alexandrospetkos/quad/resources/Photos/img3.png

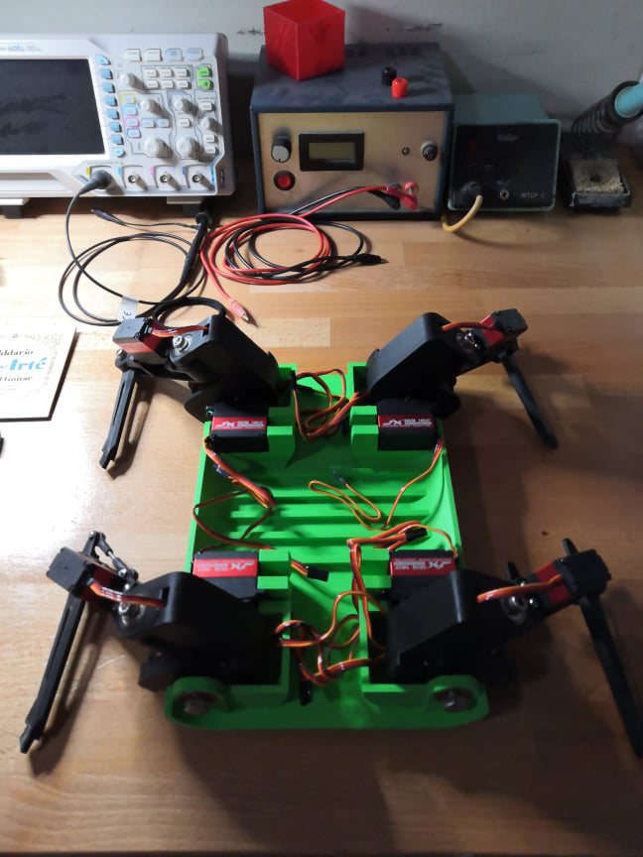
resources/Photos/img3.png
