alexandrospetkos/quad/resources/Photos/img2.png

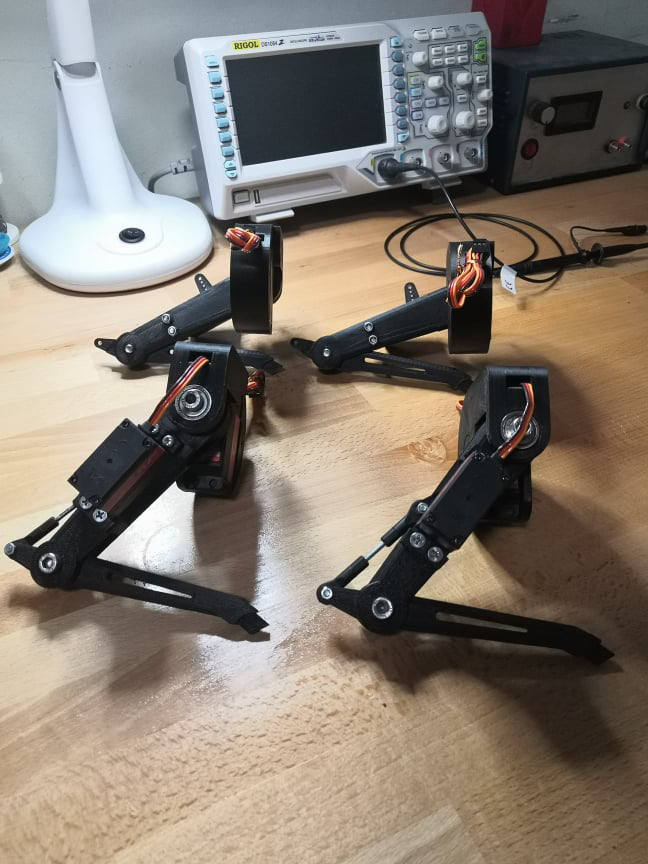
resources/Photos/img2.png
