alexandrospetkos/quad/simulation/README.md

# Warp

 Quadruped robot kinematics simulation/demonstration sketch.
 3/10/2020 by Alexandros Petkos
 Updates available at https://github.com/maestrakos/warp
 
 The code has been tested using Processing version 3.5.4 
 , this sketch is part of warp_kinematics placed under CC-BY.
