alexandrospetkos/quad/source code/source_k210/README.md

I am using the Sipeed M1 Dock with the K210 processor which handles machine vision and communicates with the Esp32 
via UART, passing three values direction-x / direction-y / turn. You essentially need 4 wires to connect 
the two boards vcc ground tx & rx.
