alexandrospetkos/quad/resources/CAD/Diagrams/diagram.png

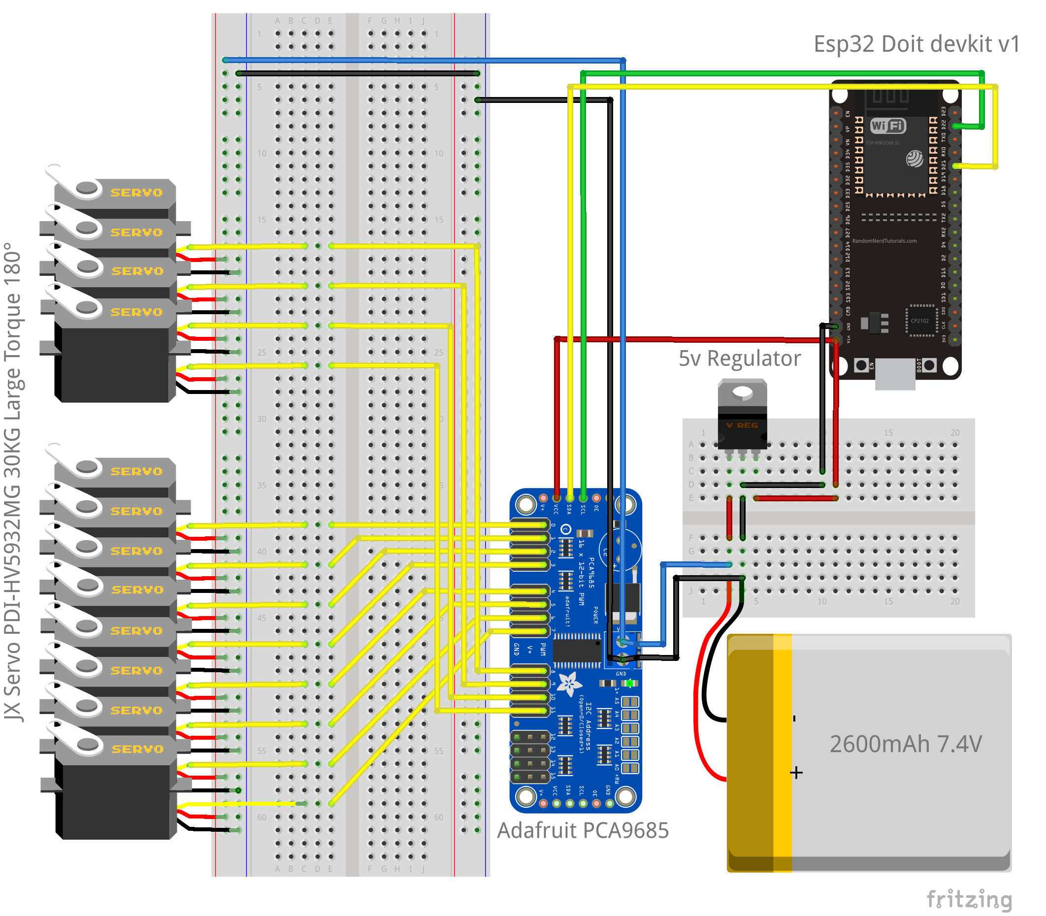
resources/CAD/Diagrams/diagram.png
