alexandrospetkos/quad/resources/CAD/Renders/preview_design.png

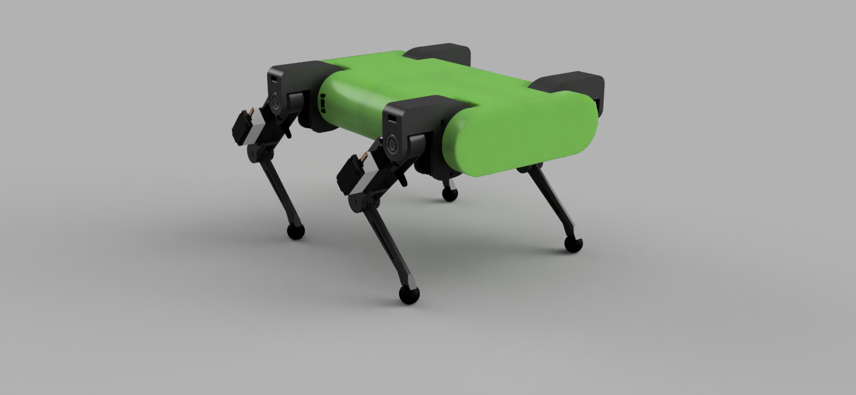
resources/CAD/Renders/preview_design.png
