alexandrospetkos/quad/resources/Photos/img0.png

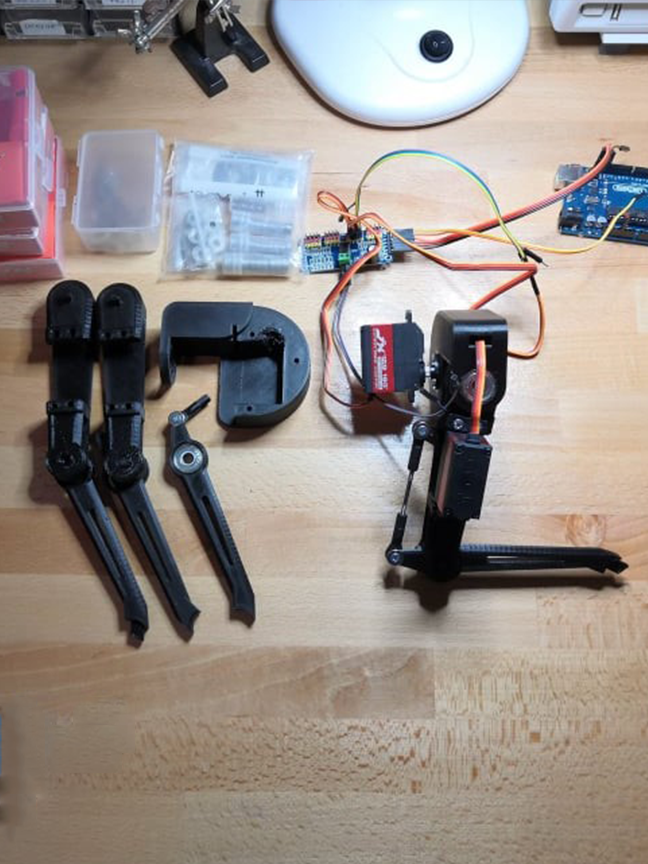
resources/Photos/img0.png
