alexandrospetkos/quad/resources/Photos/img1.png

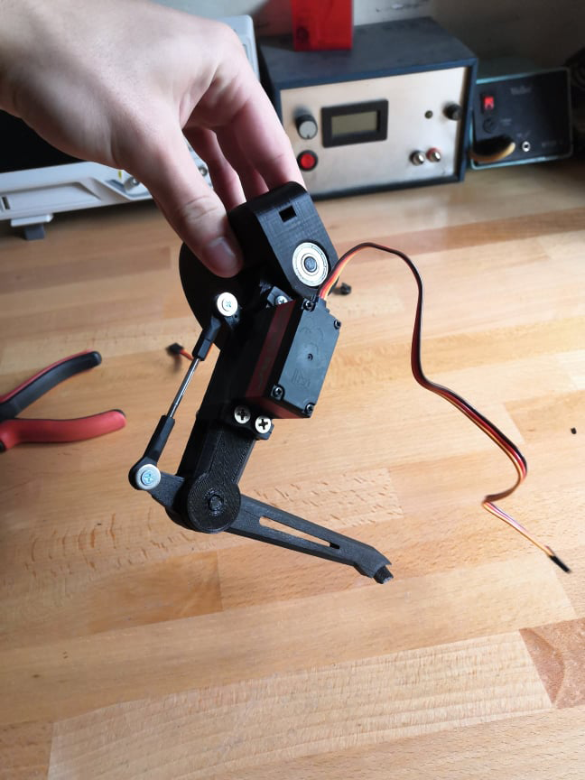
resources/Photos/img1.png
