alexandrospetkos/quad/thumb.jpg

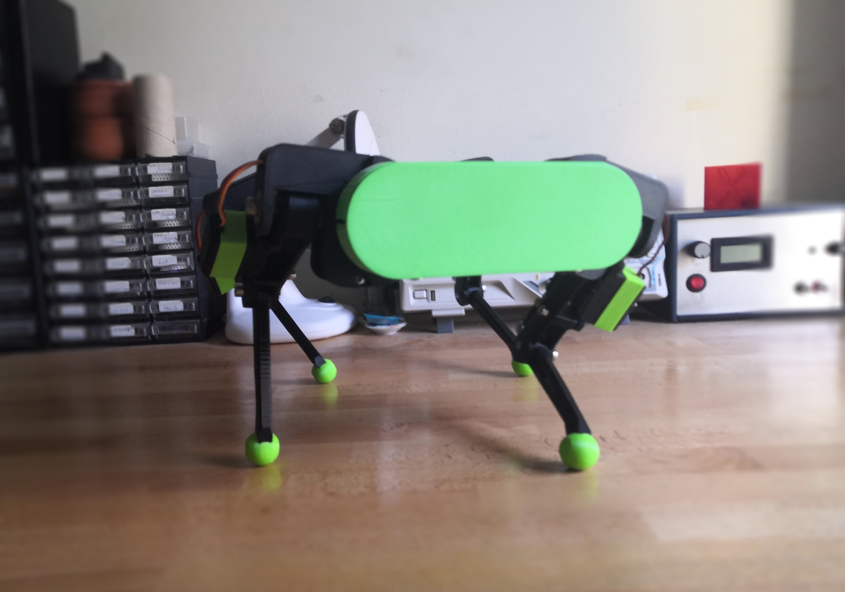
thumb.jpg
