alexandrospetkos/quad/resources/CAD/Schematics/design.pdf

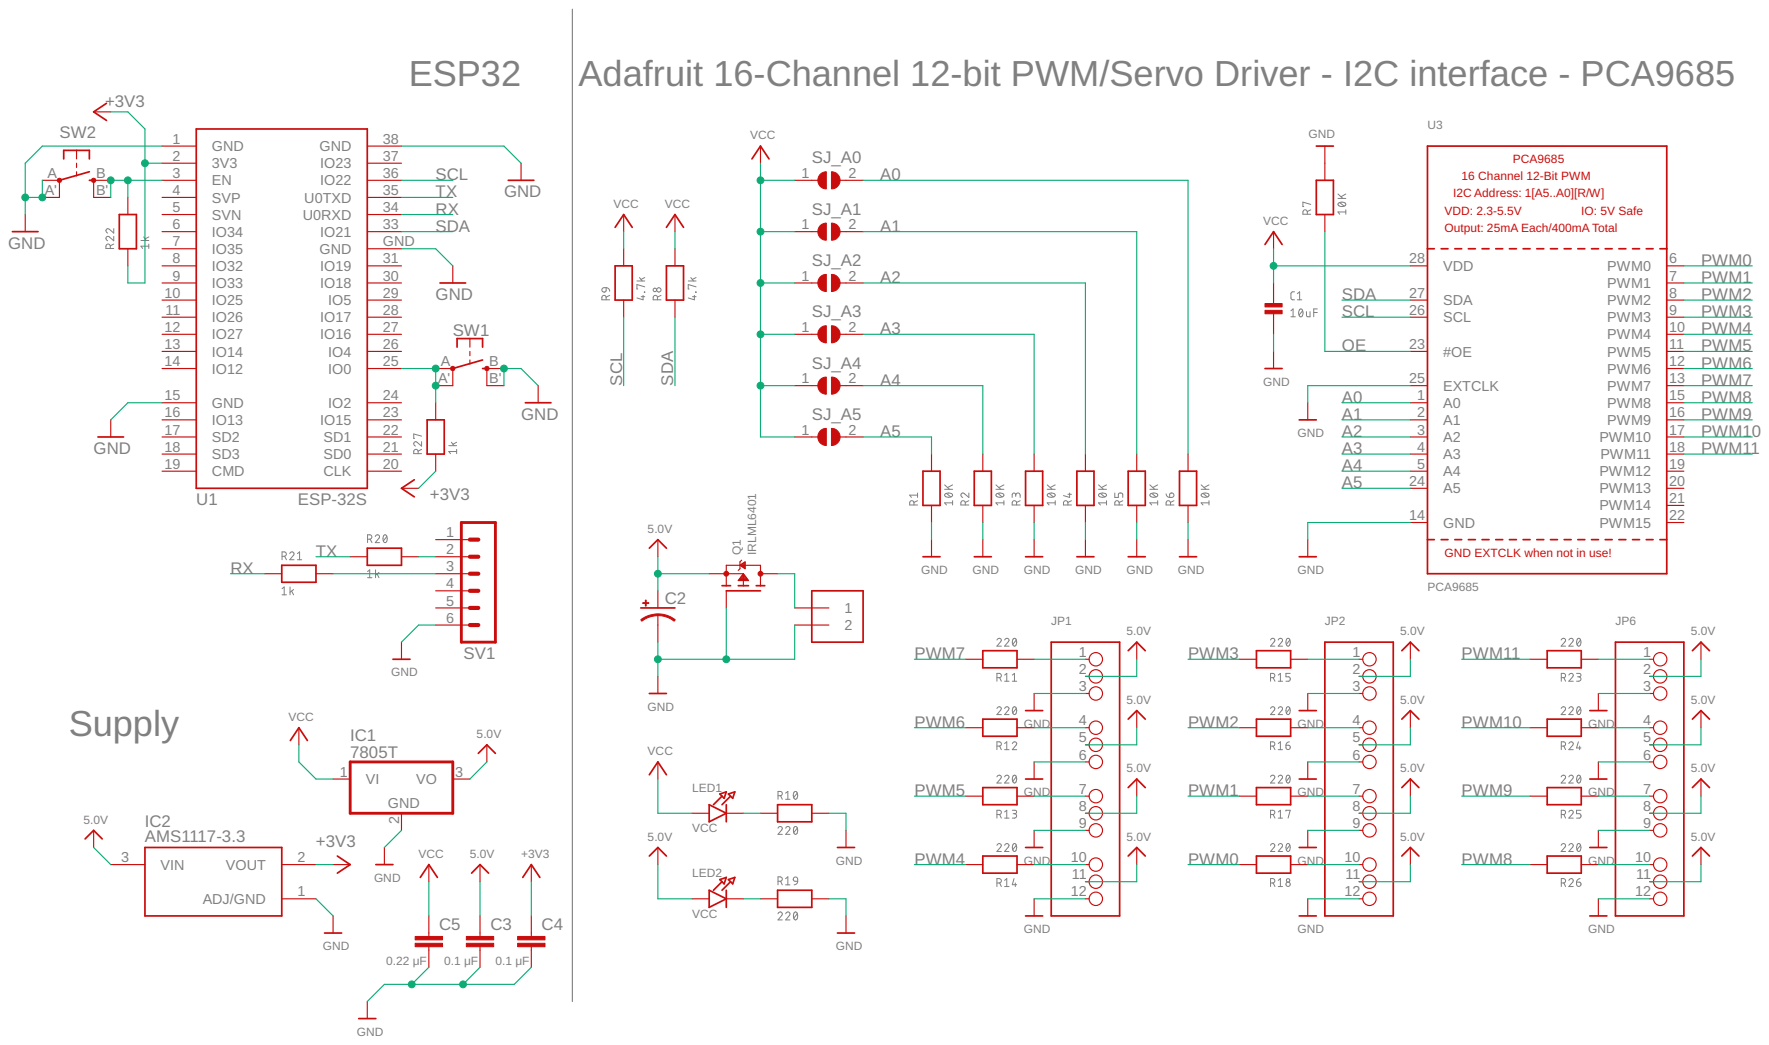
[picture p8: page 1]

Adafruit 16-Channel 12-bit PWM/Servo Driver - I2C interface - PCA9685

GND EXTCLK when not in use!
