alexandrospetkos/quad/resources/CAD/Drawings/actuator_design.pdf

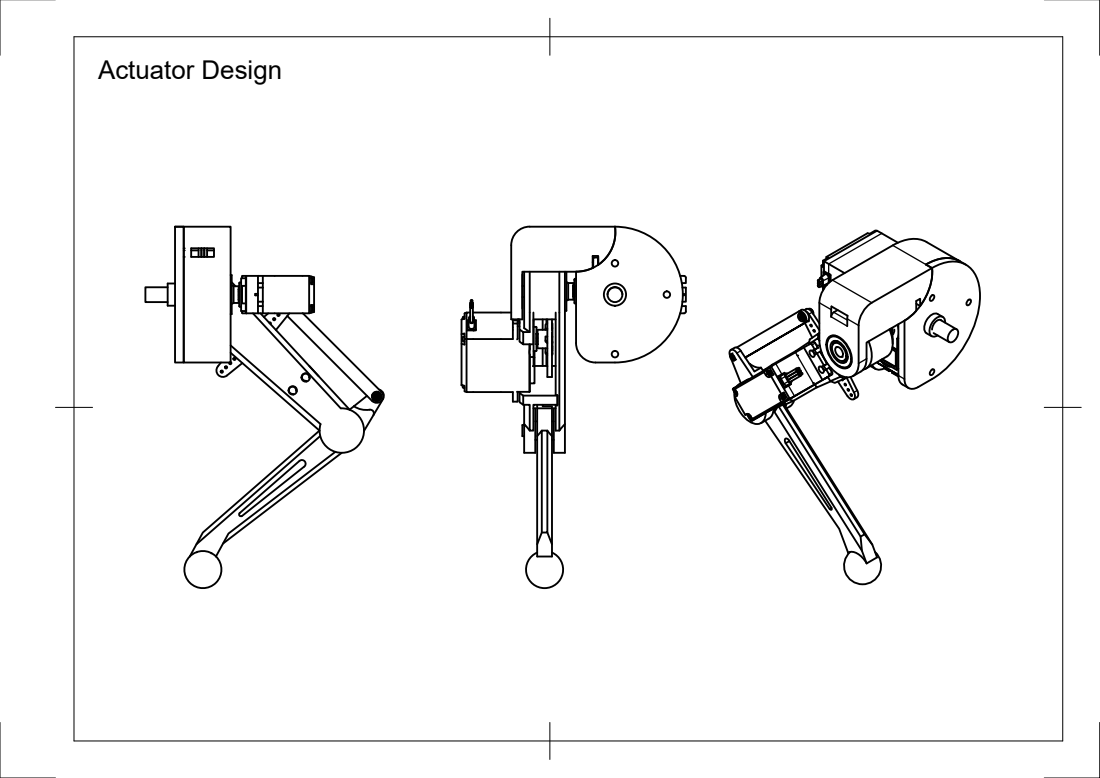
[picture p9: page 1]
Actuator Design
