alexandrospetkos/quad/resources/CAD/Drawings/body_design.pdf

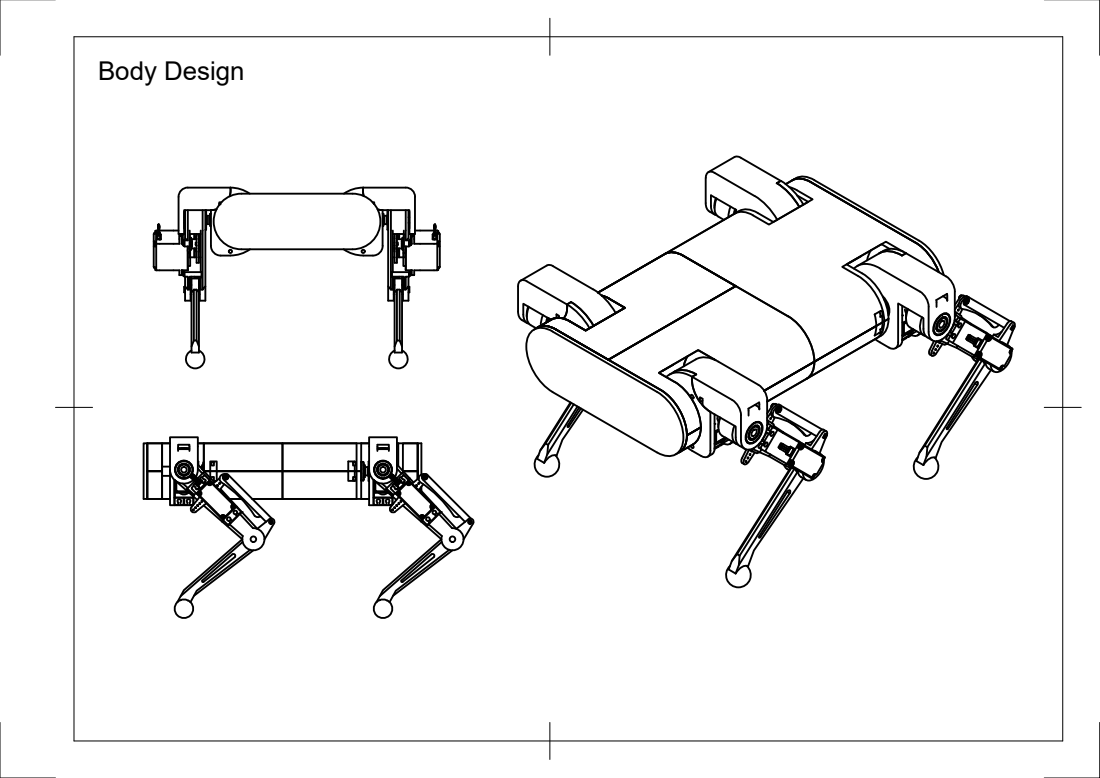
[picture p10: page 1]
Body Design
