alexandrospetkos/quad/resources/CAD/Schematics/design.sch

## EAGLE design resources/CAD/Schematics/design.sch (2020-05-19)

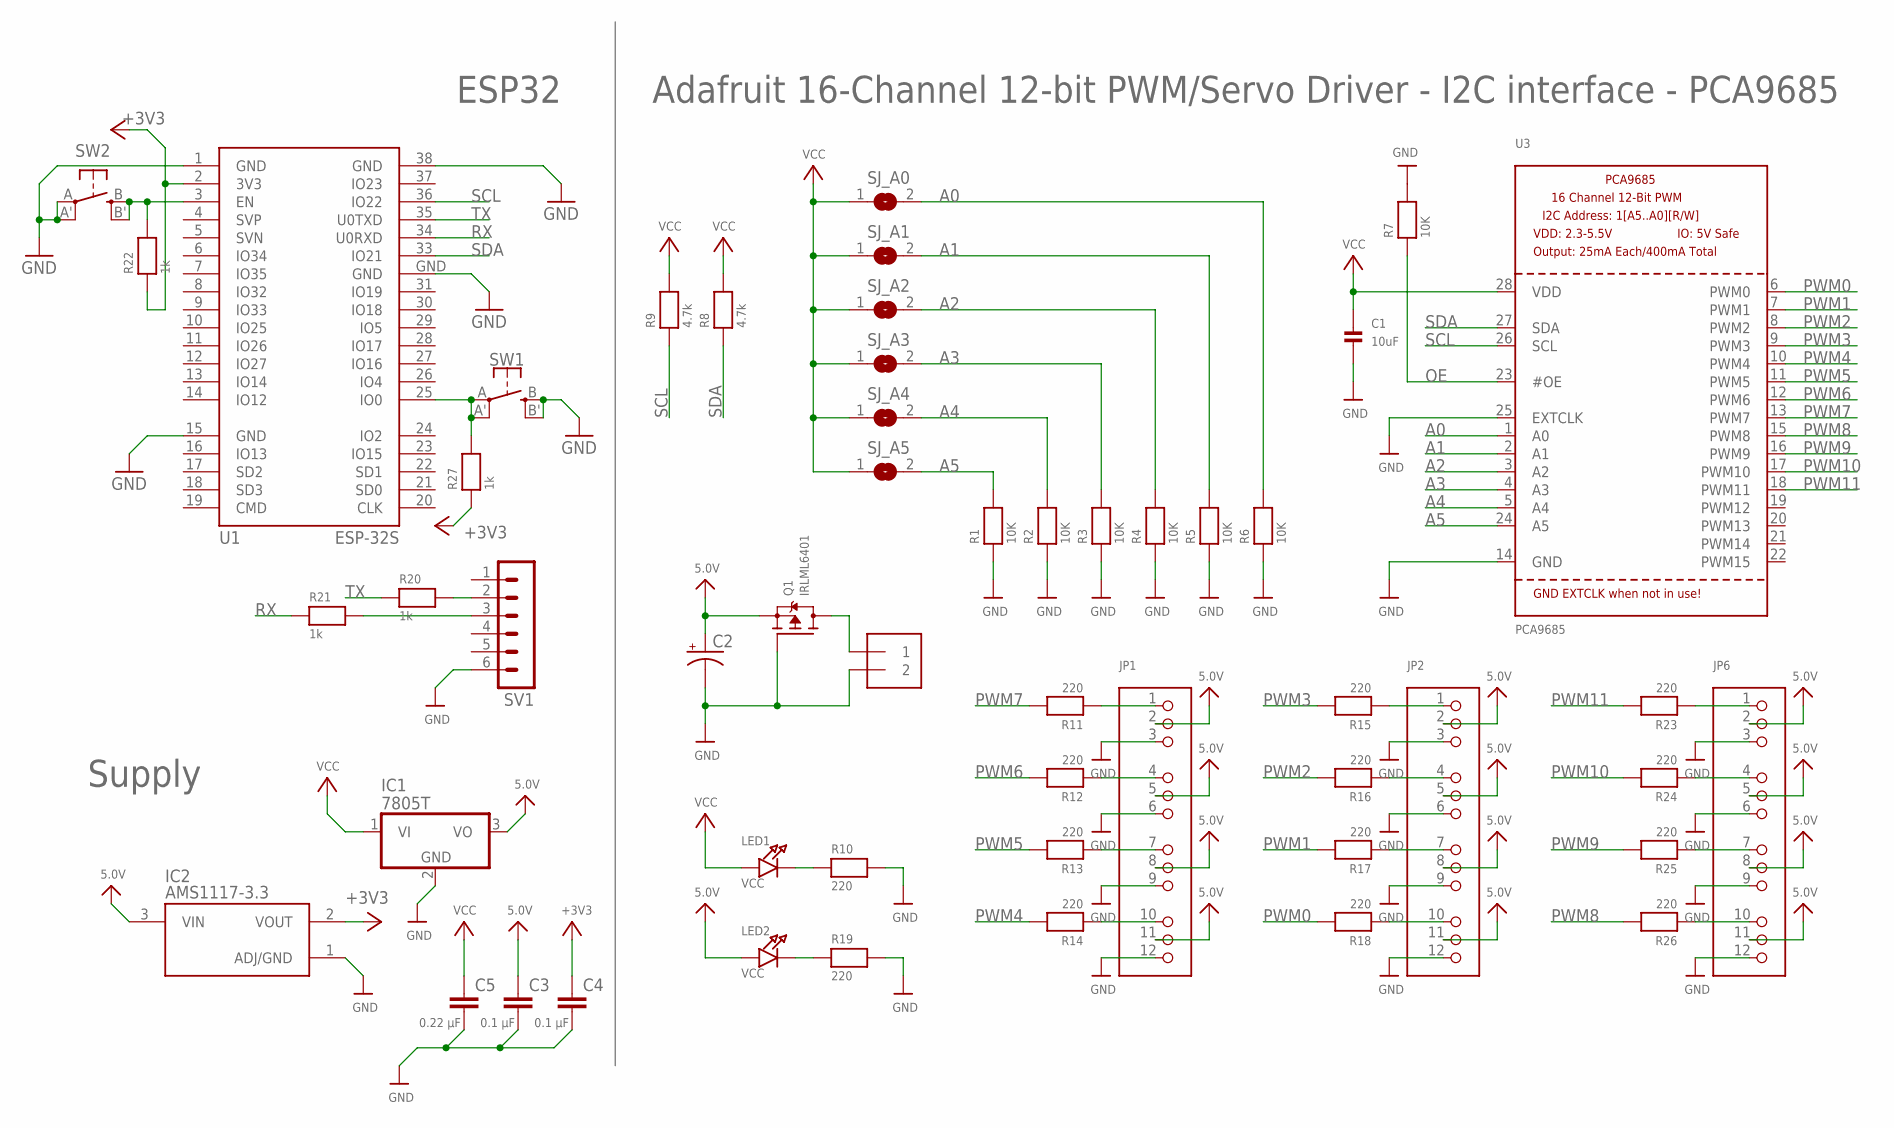
[picture p11: schematic design.sch]

Parts:
C1: 10uF; 0805
C2: CPOL-USE3.5-8; E3,5-8
C3, C4: 0.1 μF; C2.5-2
C5: 0.22 μF; C2.5-2
IC1: 7805T; TO220H
IC2: AMS1117-3.3; SOT229P700X180-4N
J1: TERMBLOCK_1X2-3.5MM; 1X2-3.5MM
JP1, JP2, JP6: HEADER-3X04; 3X04
LED1, LED2: VCC; CHIPLED_0805
Q1: IRLML6401; SOT23-WIDE
R1, R2, R3, R4, R5, R6, R7: 10K; 0805
R8, R9: 4.7k; 0805
R10, R11, R12, R13, R14, R15, R16, R17, R18, R19, R23, R24, R25, R26: 220; 0805
R20, R21, R22, R27: 1k; 0805
SJ_A0, SJ_A1, SJ_A2, SJ_A3, SJ_A4, SJ_A5: SOLDERJUMPERREFLOW_NOPASTE; SOLDERJUMPER_REFLOW_NOPASTE
SV1: MA06-1
SW1, SW2: SPST_TACT-EVQQ2; EVQ-Q2
U1: ESP-32S
U3: PCA9685; TSSOP28

Connections:
5.0V: C2.+, C3.1, IC1.3 (VO), IC2.3 (VIN), JP1.2, JP1.5, JP1.8, JP1.11, JP2.2, JP2.5, JP2.8, JP2.11, JP6.2, JP6.5, JP6.8, JP6.11, LED2.A, Q1.2 (S)
+3V3: C4.1, IC2.2 (VOUT), R22.1, R27.1, U1.2 (3V3)
A0: R6.2, SJ_A0.2, U3.1 (A0)
A1: R5.2, SJ_A1.2, U3.2 (A1)
A2: R4.2, SJ_A2.2, U3.3 (A2)
A3: R3.2, SJ_A3.2, U3.4 (A3)
A4: R2.2, SJ_A4.2, U3.5 (A4)
A5: R1.2, SJ_A5.2, U3.24 (A5)
GND: C1.2, C2.-, C3.2, C4.2, C5.2, IC1.2 (GND), IC2.1 (ADJ/GND), J1.2, JP1.3, JP1.6, JP1.9, JP1.12, JP2.3, JP2.6, JP2.9, JP2.12, JP6.3, JP6.6, JP6.9, JP6.12, Q1.1 (G), R1.1, R2.1, R3.1, R4.1, R5.1, R6.1, R7.2, R10.2, R19.2, SV1.6, SW1.B (S), SW1.B' (S1), SW2.A, SW2.A' (P1), U1.1 (GND), U1.15 (GND), U1.38 (GND), U1.GND, U3.14 (GND), U3.25 (EXTCLK)
unnamed: LED1.C, R10.1
unnamed: JP1.4, R12.1
unnamed: JP1.1, R11.1
unnamed: JP1.7, R13.1
unnamed: JP1.10, R14.1
unnamed: JP2.1, R15.1
unnamed: JP2.4, R16.1
unnamed: JP2.7, R17.1
unnamed: JP2.10, R18.1
unnamed: JP6.10, R26.1
unnamed: JP6.7, R25.1
unnamed: JP6.4, R24.1
unnamed: JP6.1, R23.1
unnamed: LED2.C, R19.1
unnamed: R21.2, SV1.3
unnamed: R20.2, SV1.2
unnamed: R27.2, SW1.A, SW1.A' (P1), U1.25 (IO0)
unnamed: R22.2, SW2.B (S), SW2.B' (S1), U1.3 (EN)
OE: R7.1, U3.23 (#OE)
PWM0: R18.2, U3.6 (PWM0)
PWM1: R17.2, U3.7 (PWM1)
PWM2: R16.2, U3.8 (PWM2)
PWM3: R15.2, U3.9 (PWM3)
PWM4: R14.2, U3.10 (PWM4)
PWM5: R13.2, U3.11 (PWM5)
PWM6: R12.2, U3.12 (PWM6)
PWM7: R11.2, U3.13 (PWM7)
PWM8: R26.2, U3.15 (PWM8)
PWM9: R25.2, U3.16 (PWM9)
PWM10: R24.2, U3.17 (PWM10)
PWM11: R23.2, U3.18 (PWM11)
PWRIN: J1.1, Q1.3 (D)
RX: R21.1, U1.34 (U0RXD)
SCL: R9.1, U1.36 (IO22), U3.26 (SCL)
SDA: R8.1, U1.33 (IO21), U3.27 (SDA)
TX: R20.1, U1.35 (U0TXD)
VCC: C1.1, C5.1, IC1.1 (VI), LED1.A, R8.2, R9.2, SJ_A0.1, SJ_A1.1, SJ_A2.1, SJ_A3.1, SJ_A4.1, SJ_A5.1, U3.28 (VDD)

Notes on the sheet:
Adafruit 16-Channel 12-bit PWM/Servo Driver - I2C interface - PCA9685
Supply
ESP32
