alexandrospetkos/quad/(notices)

Notices in the files:
parts and their libraries:
esp32: Creative Commons Attribution-ShareAlike 4.0 International
